42CrMo4/ki-lib/(commit log)

2022-10-18 Added ESP32-C3-WROOM-02-H4 Symbol/Footprint/3D
2022-12-21 Add TCK10xAF,LF Load Switch IC Family
    TCK106AF,LF; TCK107AF,LF; TCK108AF,LF
2022-12-30 Update TCK108AF,LF Pin type
    use power out instead of output type
2022-12-30 Add LED_SK6805_EC15_1.5x1.5mm
2023-10-08 ADD: Würth 6pin SKEDD connector
    WURTH:490107670612
2024-02-20 introduce Import-LIB-KiCad-Plugin with TS3USB30RSWR
    https://github.com/Steffen-W/Import-LIB-KiCad-Plugin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
2024-08-17 update Buttonpad2x2 pin numbers
2024-09-07 Add Wago 2601-3108 8 pin connector
2024-09-08 update solderpaste for legs on TYPE-C-31-M-12 USB-C
2024-10-23 Update BUTTONPAD-2X2.kicad_mod
    License and Link
2024-10-23 Update SKEDD-UPDI-4.kicad_mod
    add 3D Model
2024-11-01 make footprint proper git with kiutils
2024-11-01 chore: sync KiCAD 3D model configurations
2024-11-02 Update BM04B-SRSS-TB_LF__SN__JST_BM04B-SRSS-TB_LF__SN_.kicad_mod
    update position and rotation
2024-11-02 chore: sync KiCAD 3D model configurations (#2)
2024-11-03 Update UJ20-C-H-G-SMT-TR_CUI_UJ20-C-H-G-SMT-TR.kicad_mod
    add the 3D model and scaling for the wrl
2024-11-03 chore: sync KiCAD 3D model configurations (#3)
2024-11-03 Update UJ20-C-H-G-SMT-TR_CUI_UJ20-C-H-G-SMT-TR.kicad_mod
    add pins to paste layer
2024-11-03 Update USB_C_Receptacle_GCT_USB4130-GF-C.kicad_mod
    add solder paste for THP pins
2024-11-03 chore: sync KiCAD 3D model configurations (#4)
2024-11-24 add K3-2235S-K1
    DPDT Switch
2024-11-24 chore: sync KiCAD 3D model configurations (#5)
2024-12-09 chore: sync KiCAD 3D model configurations (#6)
2024-12-30 Add GLL1 interface connector
    gll.wf/1
2025-01-26 chore: sync KiCAD 3D model configurations (#7)
2025-01-26 chore: sync KiCAD 3D model configurations (#8)
2025-01-26 chore: sync KiCAD 3D model configurations (#9)
2025-02-08 add B3F-4055
    Omron Switch
2025-02-19 chore: sync KiCAD 3D model configurations (#10)
2025-03-16 chore: sync KiCAD 3D model configurations (#11)
2025-04-03 chore: sync KiCAD 3D model configurations (#12)
2025-04-10 Add BHAA-3
    Battery holder
2025-04-10 chore: sync KiCAD 3D model configurations (#13)
2025-04-21 chore: sync KiCAD 3D model configurations (#14)
2025-04-22 chore: sync KiCAD 3D model configurations (#15)
